AnonymousAE-MobiCom24/Polaris/Evaluation/Data/Default_Tag/RawData_1.csv

 | Time Stamp | Sensor 1 | Sensor 2 | Sensor 3 | Sensor 4 | Sensor 5 | Sensor 6 | Sensor 7 | Sensor 8 | Sensor 9
0 | 0.0 | (55.95, 9.0, 22.99) | (31.05, -13.5, 63.162) | (23.7, 7.95, 58.564) | (16.8, -5.25, 28.072) | (10.35, -15.3, 42.834) | (2.4, -5.4, 25.41) | (-4.2, -8.85, 43.318) | (9.15, -11.55, 28.556) | (0.6, -19.8, 34.122)
1 | 0.01 | (58.2, 10.65, 24.2) | (34.95, -14.55, 66.55) | (24.0, 6.3, 60.258) | (17.85, -5.25, 28.798) | (9.3, -16.35, 39.688) | (1.2, -6.3, 27.104) | (-2.7, -7.5, 40.898) | (8.25, -9.6, 27.346) | (1.65, -20.25, 32.186)
2 | 0.02 | (55.35, 9.3, 23.716) | (33.75, -14.1, 66.308) | (22.8, 4.95, 59.774) | (16.95, -4.5, 30.25) | (10.65, -14.7, 46.222) | (0.75, -6.0, 25.168) | (-2.1, -6.75, 40.172) | (8.1, -10.8, 29.766) | (1.65, -20.4, 33.638)
3 | 0.03 | (56.25, 9.15, 22.506) | (34.35, -14.1, 66.066) | (23.4, 6.45, 60.258) | (17.1, -6.0, 28.314) | (9.15, -14.55, 41.14) | (2.85, -6.9, 27.104) | (-2.7, -7.35, 41.624) | (7.95, -10.2, 26.378) | (1.2, -21.0, 34.364)
4 | 0.04 | (57.15, 10.05, 23.958) | (37.35, -17.7, 68.97) | (22.8, 6.75, 57.112) | (16.8, -4.65, 28.072) | (9.9, -16.35, 43.56) | (0.0, -6.75, 25.894) | (-1.35, -7.8, 42.834) | (7.35, -10.65, 28.072) | (3.0, -19.5, 35.816)
5 | 0.05 | (56.7, 8.4, 24.2) | (36.9, -12.6, 62.92) | (24.6, 7.2, 60.742) | (16.35, -6.15, 30.734) | (9.6, -16.05, 42.35) | (0.45, -5.25, 26.62) | (-2.1, -9.15, 45.012) | (10.05, -10.05, 29.282) | (2.1, -19.95, 32.912)
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
309 | 3.089999999999978 | (54.6, 6.75, 23.232) | (35.25, -16.8, 66.792) | (21.9, 1.5, 58.564) | (18.0, -10.65, 30.492) | (10.5, -20.7, 43.56) | (3.0, -10.8, 25.894) | (-0.45, -12.45, 41.382) | (9.15, -14.1, 27.83) | (1.95, -23.7, 34.364)
