AnonymousAE-MobiCom24/Polaris/Evaluation/Data/Default_Tag/RawData_10.csv

 | Time Stamp | Sensor 1 | Sensor 2 | Sensor 3 | Sensor 4 | Sensor 5 | Sensor 6 | Sensor 7 | Sensor 8 | Sensor 9
0 | 0.0 | (54.75, 15.15, 47.19) | (36.45, -14.4, 65.824) | (22.95, 6.0, 55.66) | (16.95, -4.8, 27.346) | (9.15, -16.35, 42.35) | (0.9, -6.45, 27.588) | (-1.35, -8.85, 39.93) | (8.25, -9.75, 28.798) | (2.85, -19.2, 35.574)
1 | 0.01 | (58.05, 9.3, 48.884) | (34.5, -13.65, 64.13) | (23.85, 3.15, 60.742) | (18.0, -4.2, 28.072) | (9.45, -15.6, 41.866) | (2.55, -5.1, 25.894) | (-2.4, -9.3, 41.14) | (8.4, -6.9, 28.798) | (2.25, -18.9, 36.3)
2 | 0.02 | (58.5, 9.9, 47.674) | (33.9, -12.3, 61.71) | (22.2, 3.75, 55.902) | (16.5, -6.75, 28.556) | (9.75, -15.6, 41.866) | (1.95, -5.85, 26.862) | (-2.7, -9.45, 41.14) | (8.55, -7.8, 29.766) | (1.2, -17.55, 35.332)
3 | 0.03 | (57.6, 8.7, 50.82) | (34.8, -13.2, 64.614) | (22.65, 1.65, 56.87) | (15.9, -5.85, 29.282) | (10.95, -16.2, 41.14) | (4.35, -8.7, 26.862) | (-2.1, -9.0, 39.688) | (8.25, -7.35, 28.798) | (4.05, -18.6, 35.816)
4 | 0.04 | (56.4, 10.65, 45.738) | (35.1, -12.15, 64.856) | (22.35, 4.35, 54.934) | (17.1, -6.6, 30.734) | (11.4, -16.95, 43.802) | (3.75, -8.85, 26.62) | (-2.85, -9.6, 41.866) | (10.05, -8.55, 28.798) | (1.35, -19.5, 36.3)
5 | 0.05 | (55.65, 7.8, 48.642) | (37.8, -13.95, 63.404) | (22.35, 4.2, 57.354) | (18.15, -6.3, 27.104) | (10.8, -16.35, 42.35) | (5.85, -9.6, 25.894) | (-0.6, -7.35, 42.592) | (8.7, -8.1, 28.798) | (2.55, -18.0, 33.396)
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
320 | 3.1999999999999758 | (55.8, 3.9, 50.336) | (34.05, -17.1, 67.034) | (22.65, 0.0, 58.322) | (17.1, -10.95, 28.314) | (10.95, -20.55, 44.044) | (2.4, -11.85, 28.556) | (-2.1, -13.2, 42.35) | (8.85, -13.35, 29.766) | (2.7, -21.6, 35.574)
