AnonymousAE-MobiCom24/Polaris/(list of files, drawings)

Other design files:
PCBs/Flashing_Module/Flashing_Board_PcbDoc.PcbDoc
PCBs/Flashing_Module/Flashing_Board_SchDoc.SchDoc
PCBs/SensorArray_MiniCar/MiniCar_SchDoc.SchDoc
PCBs/SensorArray_RobotCar/RobotCar_SchDoc.SchDoc
