AnonymousAE-MobiCom24/Polaris/(commit log)

2024-08-25 update the sensor array design
2024-08-26 update the pcb files
    [Flashing_Board_PcbDoc.PcbDoc, Flashing_Board_SchDoc.SchDoc, MiniCar_SchDoc.SchDoc, RobotCar_SchDoc.SchDoc]
2024-08-26 update the arduino setups
2024-08-28 update the PCB readme
2024-09-10 update the evaluation
    [RawData_1.csv, RawData_10.csv, RawData_2.csv, RawData_3.csv, RawData_4.csv, RawData_5.csv, RawData_6.csv, RawData_7.csv]
